JustinMaeder/Doct-senior-design-project/README.md

# Doct-senior-design-project
 CSULB 490B Senior Design Project- Doc't

Link to live demo:
https://www.youtube.com/watch?v=JGFx7sOTDQI

Link to Backend Final Demo:
https://youtu.be/M6DDF0WYpfE
