JustinMaeder/Doct-senior-design-project/CECS 490B-Final - Group Report.pdf

Doc’t 1 of 55

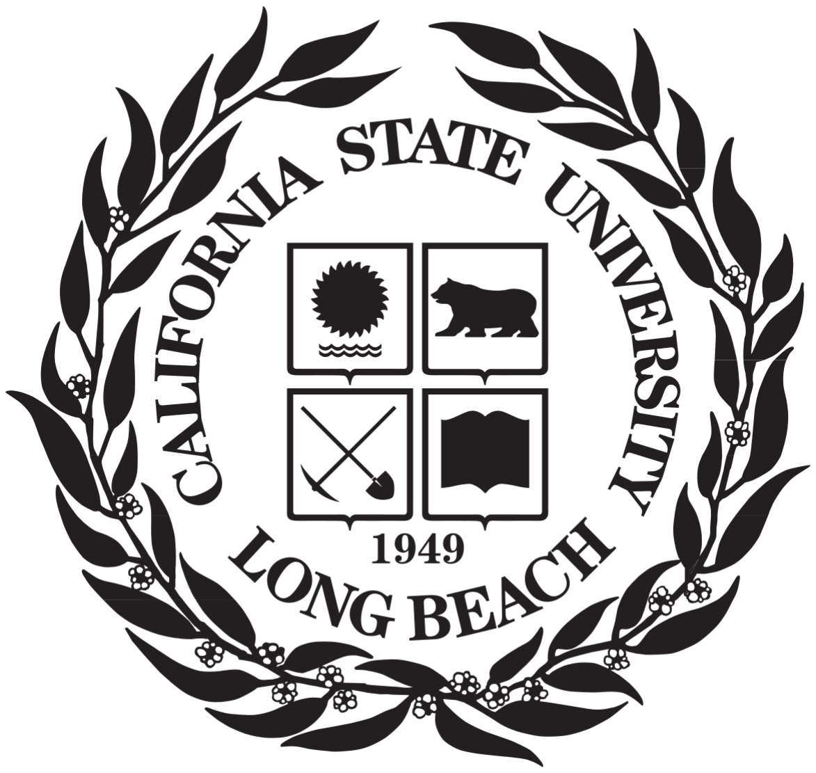
[picture p1: figure]

# Doc’t

## Final Group – Group Report CECS 490B

5-08-2020

## Justin Maeder & Hung Le

CONTENTS

1. INTRODUCTION

1.1 MEET THE TEAM

Justin Maeder

Justin.Maeder@student.csulb.edu

Responsible for:
1. Software Design
2. C++ for Arduino
3. Constructed Database
4. Created web application
5. Hardware verification

Hung Le

Hung.Le@student.csulb.edu

Responsible for:
1. Hardware Design
2. Wiring diagram
3. Hardware assembly/debug
4. Software Verification

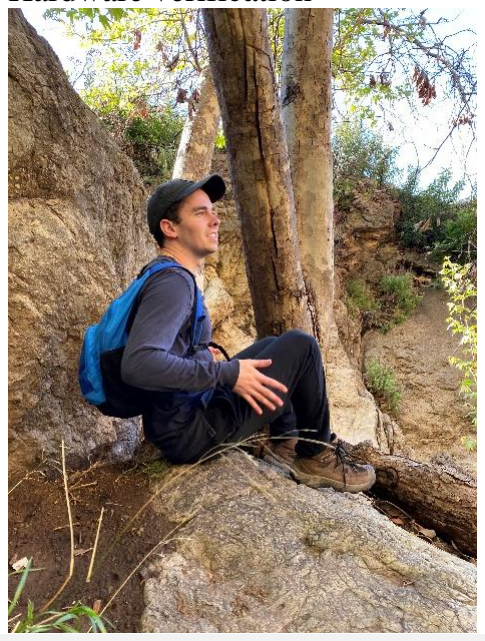
[picture p2: figure]

1.2 DOC’T

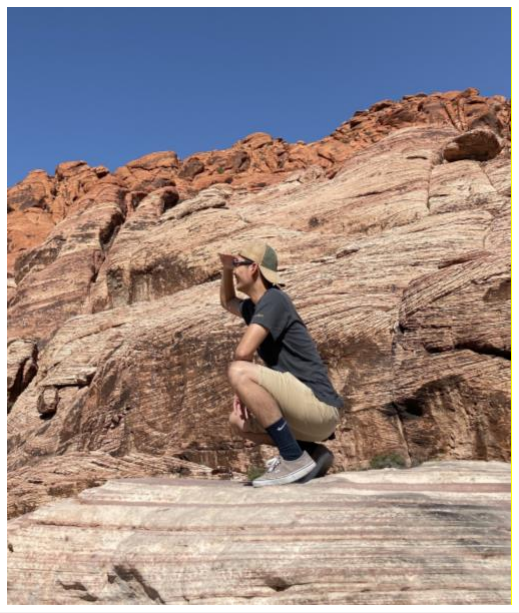
[picture p3: figure]

Doc’t is an electric transportation rental system with centralized locking and docking

charging HUBs and innovative safety equipment.

Our design consists of three main components. Primarily we will be building an Electric

Transportation System. Our ETS will include a custom electric skateboard. The second

component consists of a docking and locking HUBs. The "HUB" harnesses clean energy from

the sun using solar panels and store the energy in a power bank to charge and lock the vehicles.

Lastly, our safety features include a helmet with a Head-Up display to visualize the vehicle’s

vitals. The HUD will display the battery level, speed, range, efficiency, and current time.

2. SPECIFICATIONS

2.1 DESIGN SPECIFICATIONS
1. Frontend – Hackathon Boiler Plate with PUG JavaScript with MongoDB
a. Register User
i. Name
ii. Username
iii. Password
iv. Email
b. Login
c. Book Ride
i. Show closest available vehicle ii. Shows PIN
d. Forgot Password
e. Contact Page
f. Status of the server
g. My Account (Profile)
2. Backend
a. Using MySQL with PhpMyAdmin to interface
b. Virtual private server through Digitalocean:
i. 1 GB RAM
ii. 25 GB SSD
iii. 1 CPU
iv. 1 TB data transfer
v. $5.00/ month
1. ALL user registration information
2. Vehicle Information
a. Check in/out time
b. Range
c. Battery Usage
d. GPS
e. PIN
3. HUB – Charging Station
a. Charging station consists of a deep cycle SLA battery of 9AH. Enough to charge one vehicle from 0% to 100%.
b. This battery is recharged by a 25W solar panel.
c. A solar charge controller is used to safely charge the battery overtime.

d. Lastly a 500W inverter will convert the DC power from the battery to AC to charge the vehicle.
4. Physical Locker space:
a. The locking mechanism on the locker space will be controlled by the TTGO TCALL.
b. Locker space consists of the lockers with electronic locking solenoid and a keypad.
c. The system will be powered by the central battery and stepdown using the 7805-voltage regulator.
1. Locking mechanism
a. GPIO communication w/ each lock
2. Solar Panel Mounting
a. Deliver power to controller
3. Battery storage
a. Battery capacity to support number of ETS
4. Keypad for PIN input
5. Transportation Vehicle:
a. Physical vehicle
i. Deck
ii. Trucks
iii. Wheels
iv. Bearings
v. Motor mount
b. DC Motor
i. Single brushless belt driven DC motor that can generate 2900 Watts.
c. Electronic speed control module
i. Remote Control
ii. 7-segment display
d. Battery Bank
i. Dual battery bank that can provide a range of 7-8 miles range.
1. 5000mAh
e. ESP32 TTGO TCALL
i. GPS module
ii. Sim Card
6. Safety:
a. Helmet:
ii. Starting mechanism:
1. ETS will not function w/o the helmet strapped. iii. Head Up Display:
1. Arduino Nano driving OLED display:
a. Battery percentage
b. Speed
c. Range

d. Current Time
2. Bluetooth Communication using HM-10 transceiver
a. Remote
b. Vehicle
c. Helmet

2.2 MAIN COMPONENT DESCRIPTION

2.2.1 HUB

- ESP32 TTGO T-Call SIM800L for its internet connectivity and Bluetooth capabilities
- Power consumption: 2.85 W (~500mA) – 7.6 W (~640 mA) (idle – load)

The HUB will have its operating system that will allow users to reserve a locker space or to

borrow an electric transport. It will then display the available lock number to the user. If the user

wants to reserve a space, then it will prompt the user to enter a PIN to unlock the locker. The

main console will keep track of the time that the locker is being used and the power being

consumed if there is any.

An app will be available to the user so their information can be logged into the system and

communicates the information to the HUB. This will allow for ease of use where the user can

reserve space or transport using the app and arrive at the station with their space ready to use. To

conserve power, the HUB will go into sleep mode when it has been idling for a certain amount of

time.

HUB is completely self-sufficient in terms of power generation. Arrays of 25w solar panels.

HUB will also oversee the power level of the battery and the output levels of the solar panels.

Depending on the power of the battery, the power output to the users will be adjusted to prevent

the battery from going empty.

Skateboard will have 80-Watt Hour battery (36V at 4.5A) – range 7-8 miles. HUB will

consume around 3-8 Watts. Solar Panel outputs around 25 Watts. To support one skateboard a battery will have to be able to output at least 100W per skateboard. This is scalable to the

number of electric transport that the station will accommodate.

2.2.2 TRANSPORTATION VEHICLE

- C6374 – 170kV brushless belt driven DC Motor that generates 2900W chosen for reliability and cost.
- Turnigy 3s 5000mAh Battery bank for 80-Watt Hour to give the transportation vehicle 7-8 miles range.
- Using our current longboard for prototyping as we have not decided yet on a chassis.
- ESC (electric speed controller)

What is the appeal to those who cannot ride a skateboard? Doc’t presents an all-inclusive

solution by transforming into an easy-to-ride scooter all at the rider’s fingertips. When the

rider pulls up to the HUB, they will have the option to check out a scooter handlebar on the

reservation app which will click and lock into place on the transportation vehicle deck. The

remote will include a throttle potentiometer, a 1.5V battery, and LEDs to display the current

setting.

On the electric transportation vehicle side, we will have an ESC (electric speed

controller) to drive and control the motor. It will communicate via Bluetooth with the remote

to change motor speed and direction. The ESC will also monitor the battery level and an

ESP32 will transmit that data to the safety system.

2.2.3 SAFETY SYSTEM

Our Rider’s safety is the number one priority. Here are a few ways to ensure the safety of

transportation. First, we created to have a smart helmet. This will also cause the transportation

vehicle to active ensuring that the rider is wearing the helmet. The smart helmet will have a

Head-Up display which will display the board’s vitals such as batter level, range, speed, current

and time.

3. PARTS REQUIRED

3.1 SAFETY SYSTEM

3.1.1 HEAD UP DISPLAY

Part name | Quantity
Arduino Nano | 1
HM-10 Bluetooth module | 1
Adafruit MicroLipo Battery Charger | 1
3.7V 850 mAh lipo battery | 1
DIY mall 0.96” OLED module | 1
100mm double convex glass lenses | 1
0.096” thick acrylic sheet | 1
Mirror | 1
3d printed casing | 5

3.2 VEHICLE

3.2.1 DRIVING MECHANISM

Part name | Quantity
Longboard skateboard | 1
C6374 brushless motor 170Kv | 1
Electric Skateboard flywheel pulley drive kit | 1
Single motor electric skateboard controller ESC | 1
6S 25.2V Li-ion 18650 Lithium Battery BMS | 1
XT60 battery connectors | 2
Nano Sim Card | 1

3.2.2 GPS SYSTEM

Part name | Quantity
ESP-32 TTgo T-call | 1
REYAX RY8253F 10Hz GPS module | 1
BINZET DC Converter step down regulator 5V | 1

3.3 LOCK & DOCKING HUB

3.3.1 POWER SYSTEM

Part name | Quantity
Renogy Wanderer 10 Amp 12v/24v PWM Solar charge controller | 1
ECO-WORTHY 12v 25w Solar Panel | 1
ML9-12 12v 9Ah Rechargeable SLA battery | 1
POTEK 500W Inverter DC 12v to AC 110v | 1

3.3.2 LOCKING SYSTEM

Part name | Quantity
ESP-32 TTgo T-call | 1
Adafruit 3x4 matrix keypad | 1
GROVE relay module | 1
Atoplee Electric Lock Assembly Solenoid DC 12v | 1
12V battery source | 1

4. CONTRUCTING DESIGN

4.1 SAFETY SYSTEM

4.1.1 HARDWARE

3D PRINTED CASING

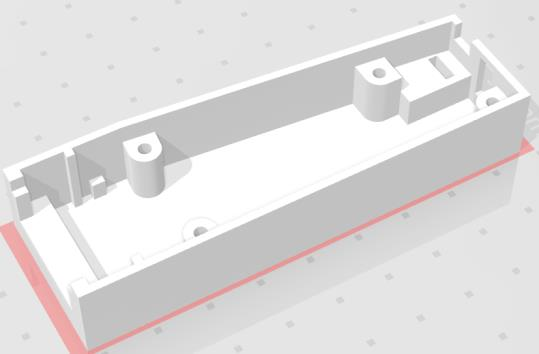
[picture p4: figure]

Figure 1 - PART A

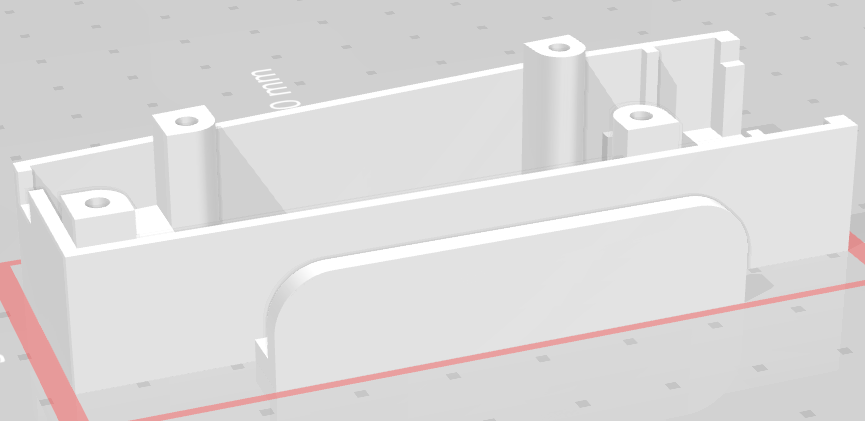
[picture p5: figure]

Figure 2 - PART B

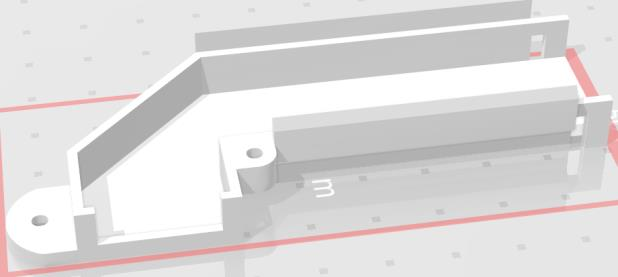
[picture p6: figure]

Figure 3 - PART C

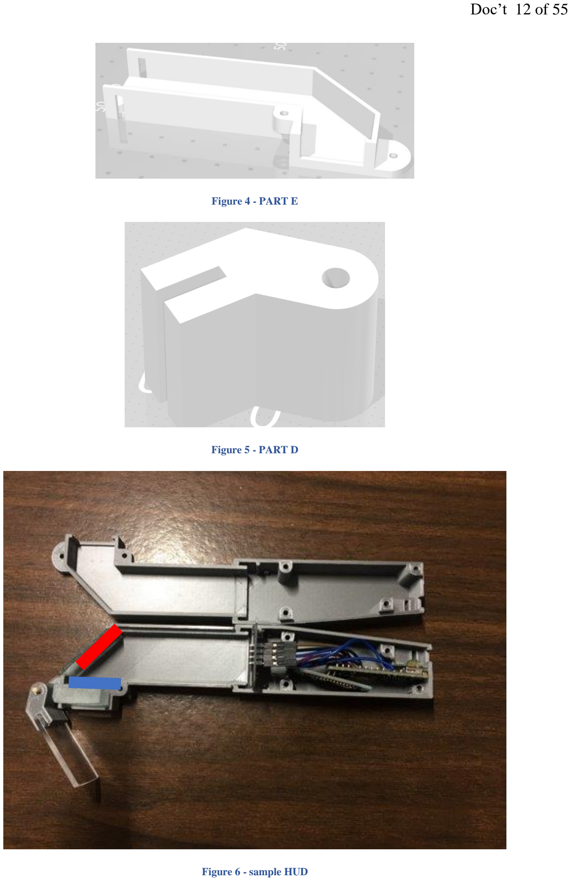
[picture p7: page 12]

Figure 4 - PART E

Figure 5 - PART D

Figure 6 - sample HUD

- The Head Up Display casing can be 3d printed with the 3d model provided below.
- Cut the mirror to fit into the red space above.
- Cut the double convex lens to fit into the blue highlight space
- Cut acrylic sheet into 1”x1.5”in rectangle and secure with glue into part D.

WIRING DIAGRAM

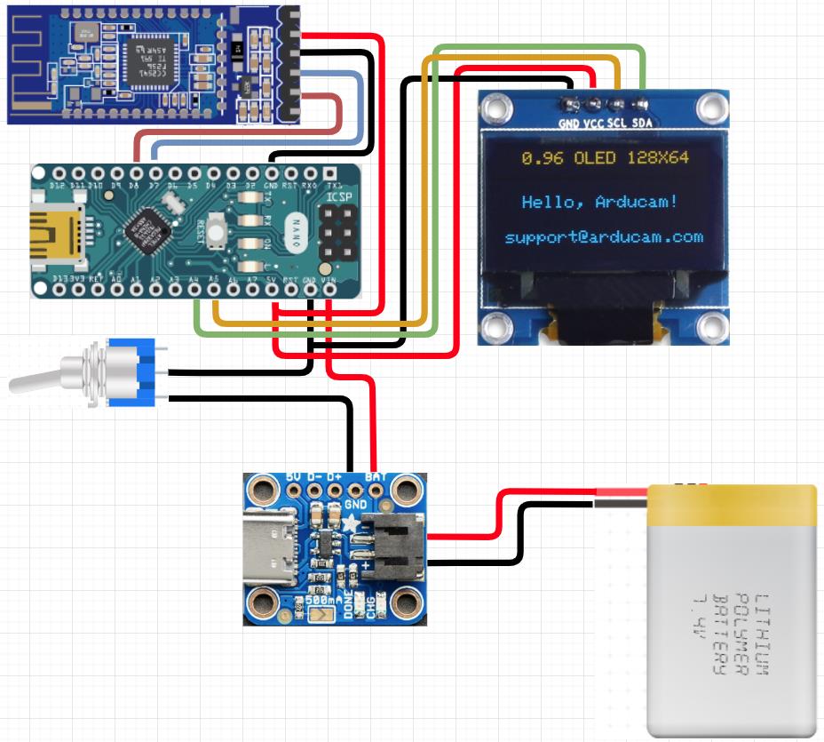
[picture p8: figure]

Figure 7 - HUD wiring

ASSEMBLED DESIGN

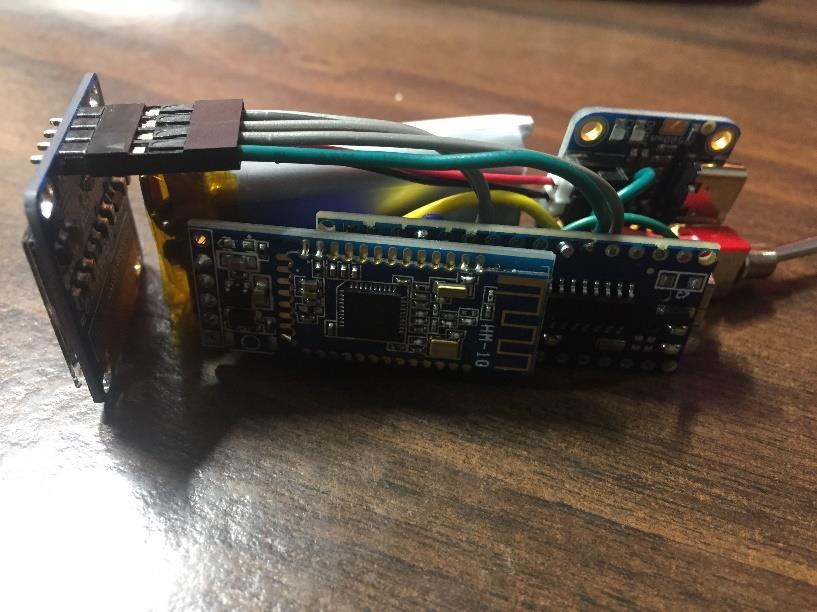
[picture p9: figure]

Figure 8 - Assembled HUD 1

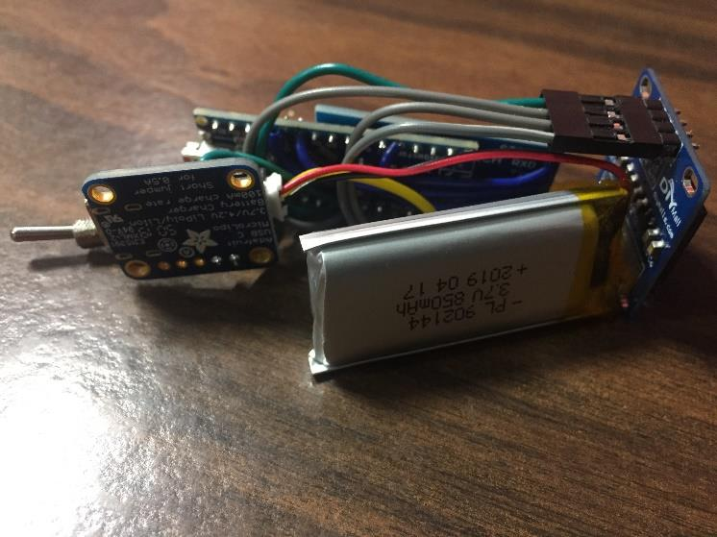
[picture p10: figure]

Figure 9 - Assembled HUD 2

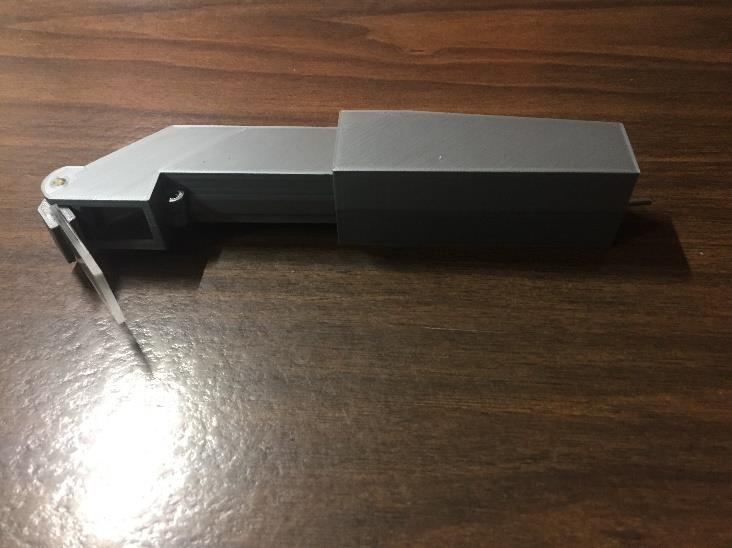
[picture p11: figure]

Figure 10 - Assembled HUD 3

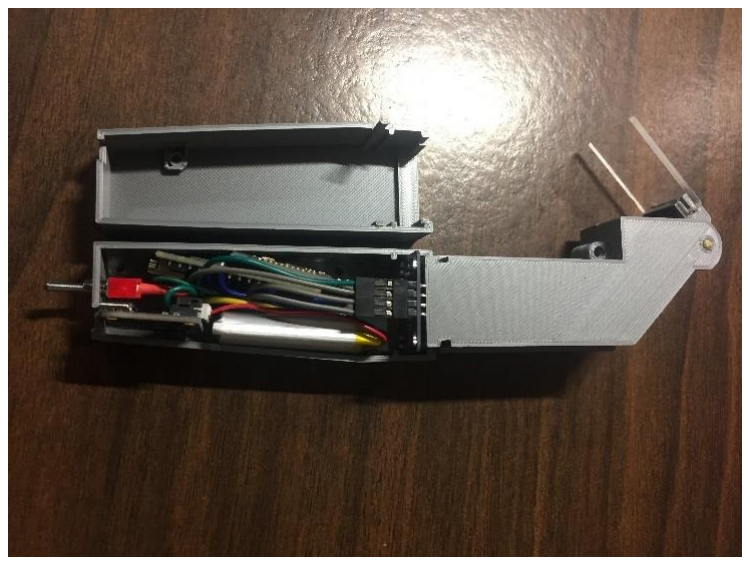
[picture p12: figure]

Figure 11 - Assembled HUD 4

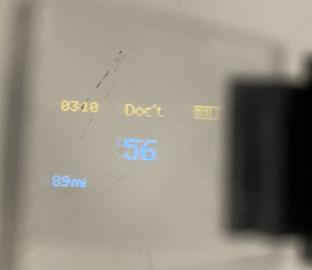
[picture p13: figure]

Figure 12 - Head up display view

4.1.2 SOFTWARE DESCRIPTION

Full software files provided bellow.

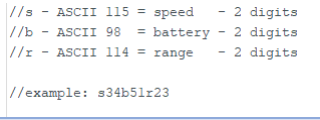
[picture p14: figure]

Input string to send to HM-10

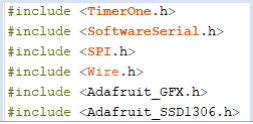
[picture p15: figure]

Libraries used.

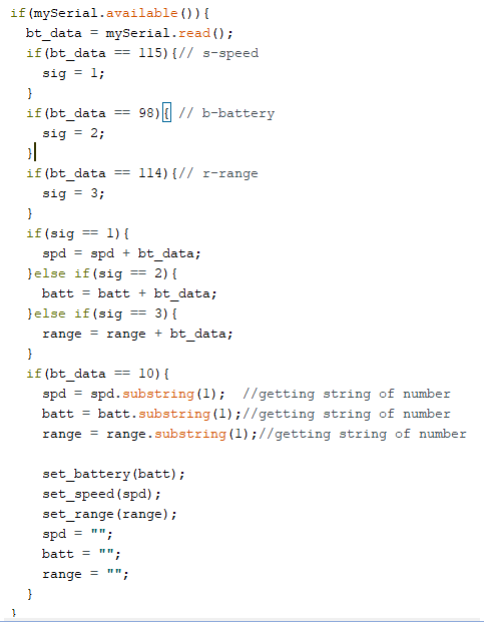
[picture p16: figure]

Decoding method to decode
data according to inputs

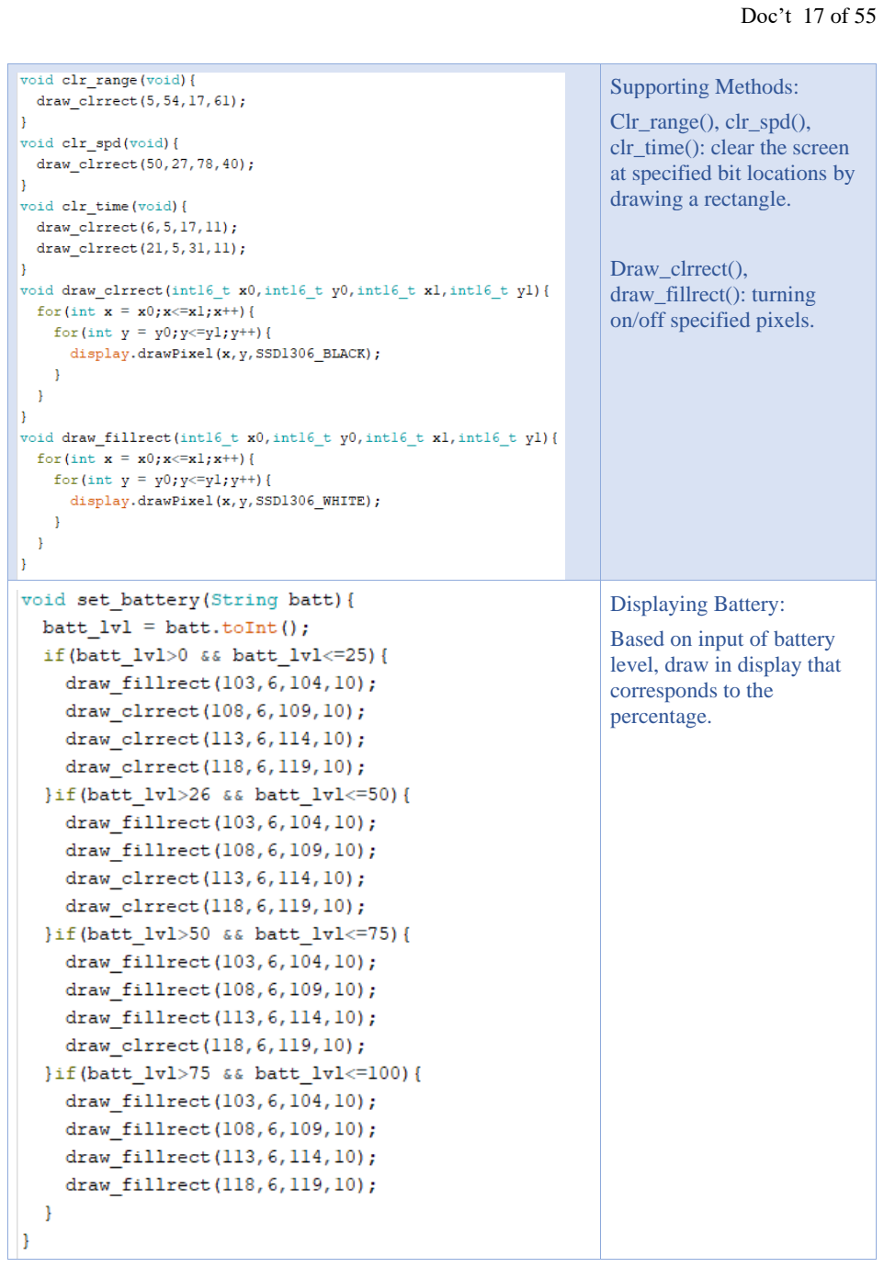
[picture p17: page 17]

Supporting Methods:
Clr_range(), clr_spd(),
clr_time(): clear the screen at specified bit locations by drawing a rectangle.

Draw_clrrect(),
draw_fillrect(): turning
on/off specified pixels.

Displaying Battery:
Based on input of battery
level, draw in display that corresponds to the
percentage.

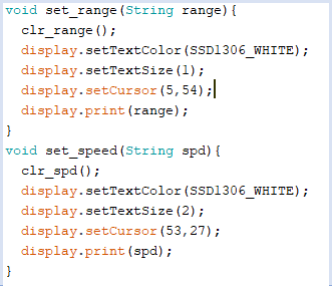
[picture p18: figure]

Display range/speed:
Based on input of speed and range. Write the numbers on the display at specified
locations.

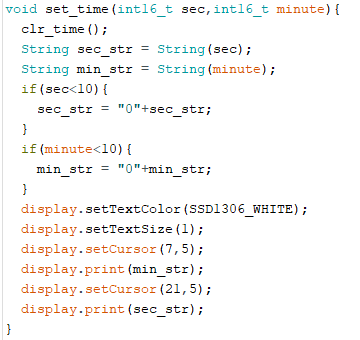
[picture p19: figure]

Timer:
Display the timer since the device has been powered
on. Time is in hr-min
format.

4.2 VEHICLE

4.2.1 HARDWARE

DRIVING MECHANISM

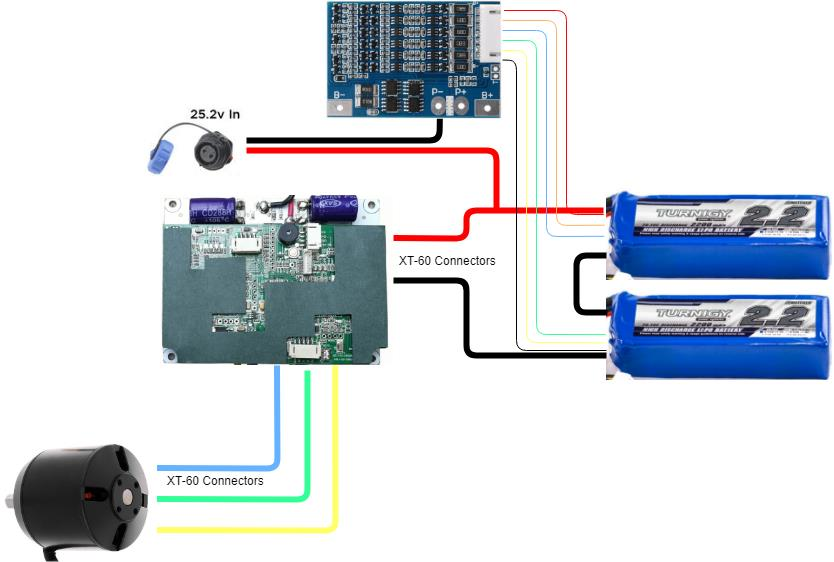
[picture p20: figure]

Figure 13 - Driving system connection

- 5000mAh 11.1V batteries, BMS (battery management system), connectors.
- Connect the two batteries in series using connectors.
- Wire BMS in parallel with batteries. BMS will be used to charge the batteries.
- Connect battery to ESC
- ESC and remote
- Connect power input wires to battery.
- Connect the 3 phase wires to motor. Connect motor control wires to ESC.

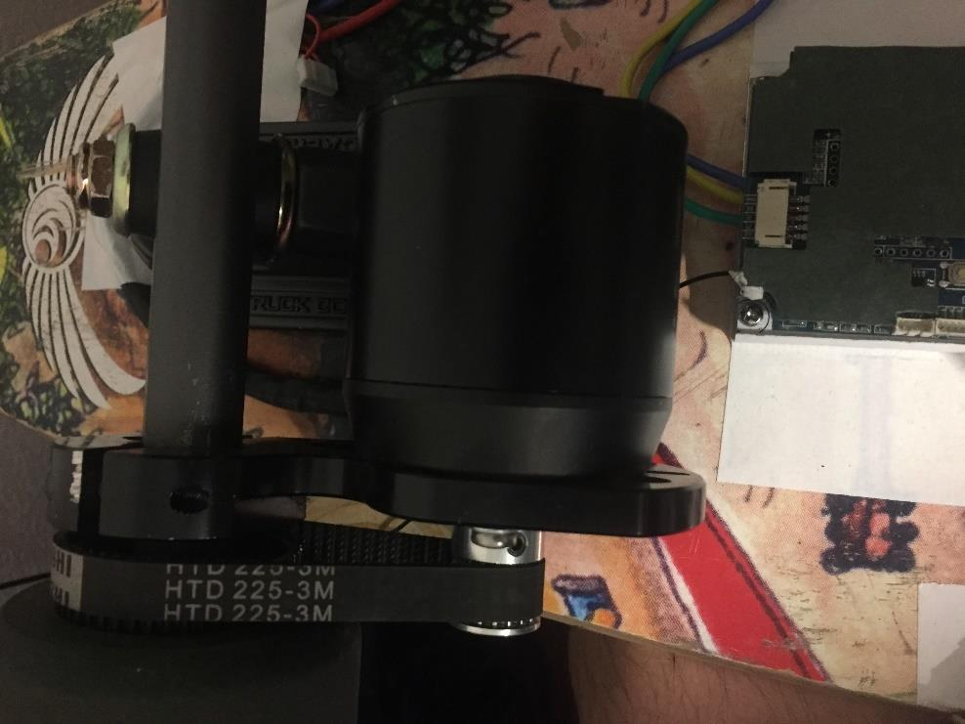
[picture p21: figure]

Figure 14 - Motor Mounting

- Trucks, motor mount, pulley system, motor, wheels.
- Bolt front and rear trucks to board.
- Attach motor mount to rear truck. Bolt motor onto motor mount.
- Attach pulley gear to motor. Attach pullet gear to wheel. Put drive belt connecting motor and wheel.

GPS SYSTEM

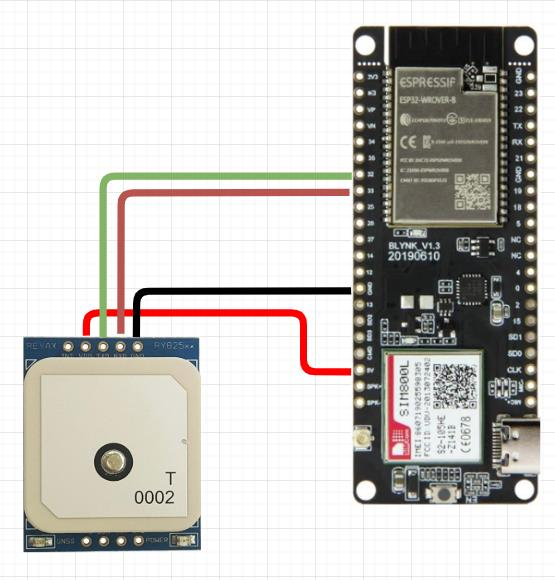
[picture p22: figure]

Figure 15 - GPS-ESP32 Wiring

- LILYGO TTGO T-Call V1.3 ESP32, REYAX RY8253F 10Hz GPS, SIM card
- Setup ESP32 to communicate with server.
- Setup ESP32 for Bluetooth communication.
- GPS module connected to ESP32 via UART protocol. ESP32 will receive GPS data and send data of the location back to the server via 2G.

ASSEMBLED DESIGN

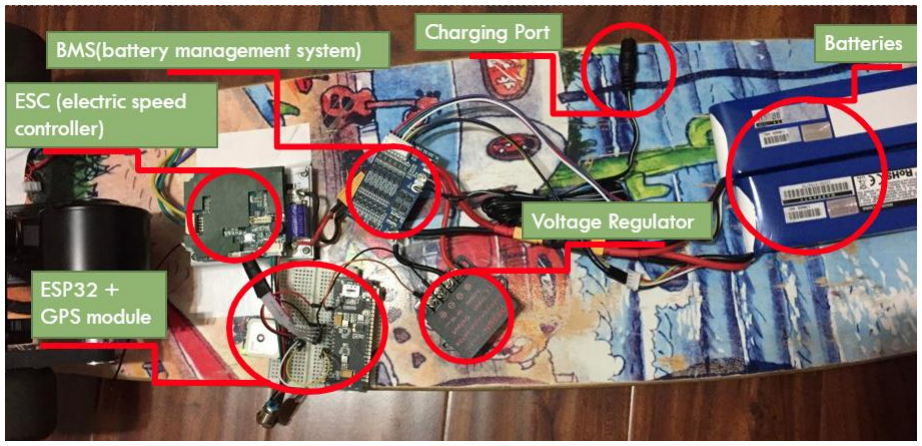
[picture p23: figure]

Figure 16 - Assembled vehicle

4.2.3 SOFTWARE DESCRIPTION

- GPS tracking:
- ESP32 development will be in Arduino IDE environment using C.
- Set up UART communication between GPS module and ESP32. Each vehicle will have an identifying number.
- Process GPS data. Send out GPS data along with identification number to server via data using 2G network.
- Location will be sent every 15 seconds.

Libraries used.

APN, Server, Port setup

Feeding data from GPS module to TinyGPS++ library.

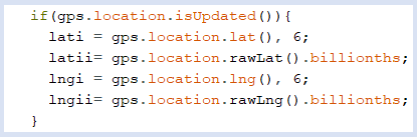
[picture p24: figure]

Get latitude
and
longitude to
the billionths
decimal
place from
GPS
module.

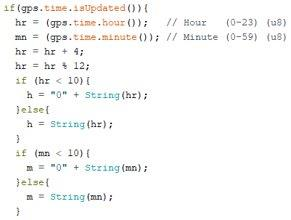
[picture p25: figure]

Get an
accurate
time Pacific
Standard
time with
Spring Day
Light
Savings
Time taken
from GPS
module.

Library for Bluetooth connection.

MAC ID of HM-10 for connection.

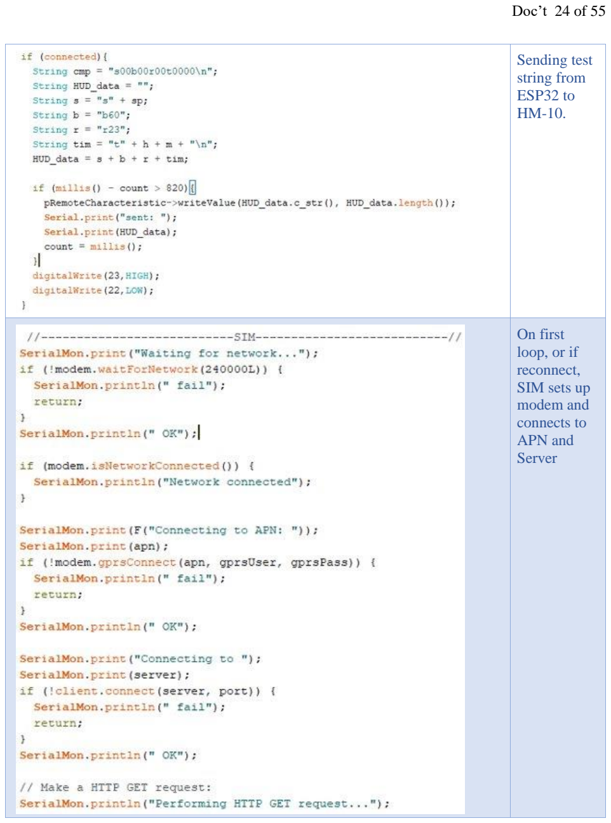
[picture p26: page 24]

Sending test
string from
ESP32 to
HM-10.

On first
loop, or if
reconnect,
SIM sets up
modem and
connects to
APN and
Server

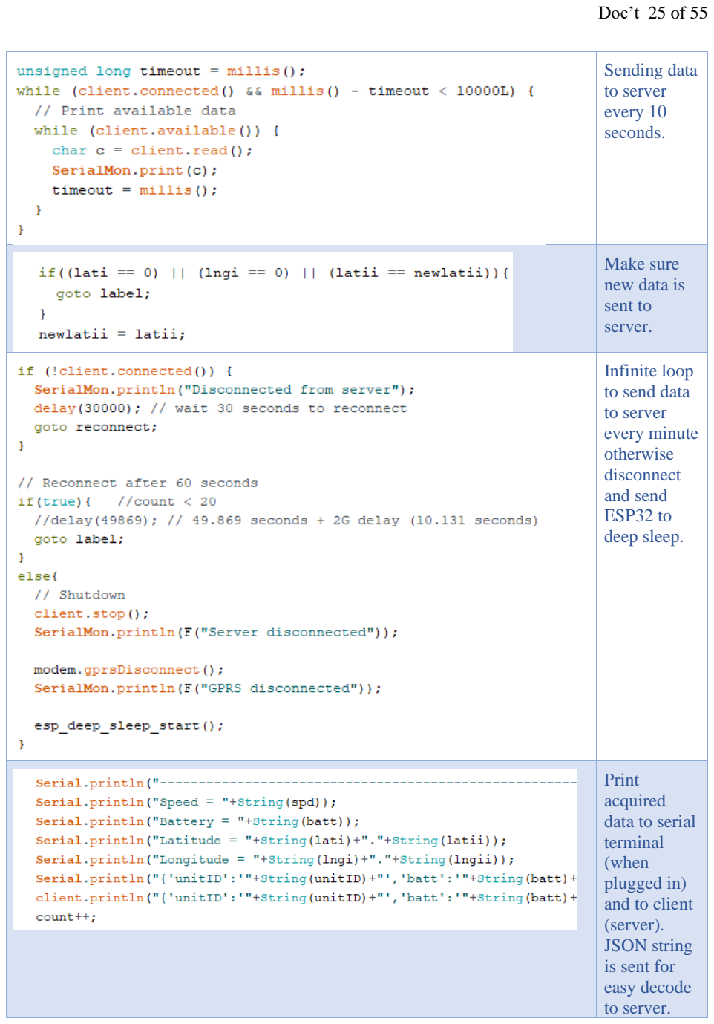
[picture p27: page 25]

Sending data to server every 10 seconds.

Make sure new data is sent to server.

Infinite loop
to send data
to server
every minute
otherwise
disconnect
and send
ESP32 to
deep sleep.

Print
acquired
data to serial
terminal
(when
plugged in)
and to client
(server).
JSON string
is sent for
easy decode
to server.

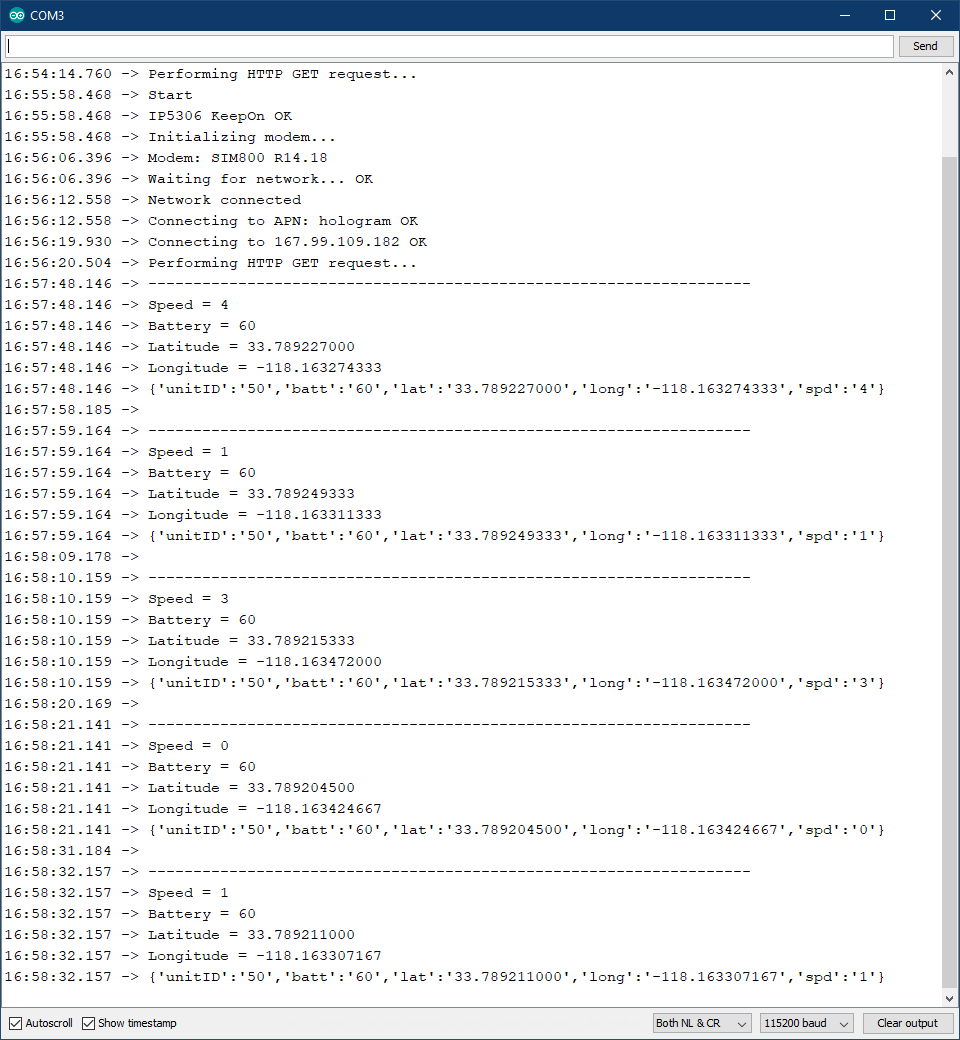
[picture p28: figure]

Figure 17 Serial Terminal for vehicle showing outputs and sent JSON data from vehicle 2G SIM every 10 seconds.

4.3 LOCKING & DOCKING HUB

4.3.1 HARDWARE

LOCKER

- The locker can be constructed from any desired material (wood, metal). Locker should be

large enough to fit the vehicle. This locker is smaller for demonstration purposes.

- Note in figure 17, there is a slit in the door for the wires to connect to the keypad.

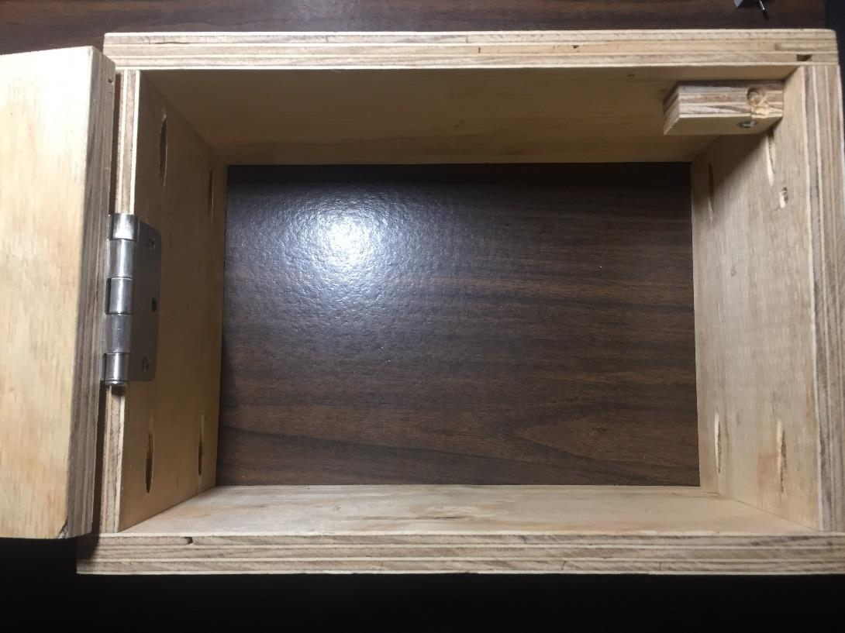
[picture p29: figure]

Figure 18 - Locker inside

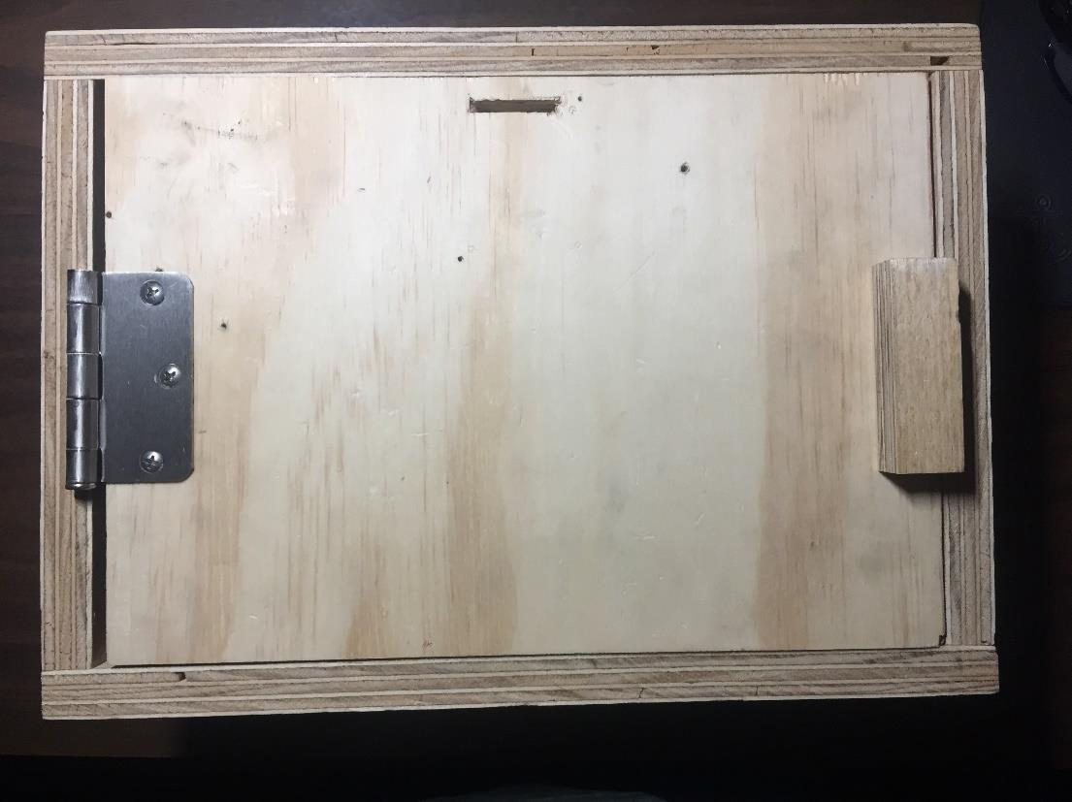
[picture p30: figure]

Figure 19 - Locker outside

LOCKING MECHANISM

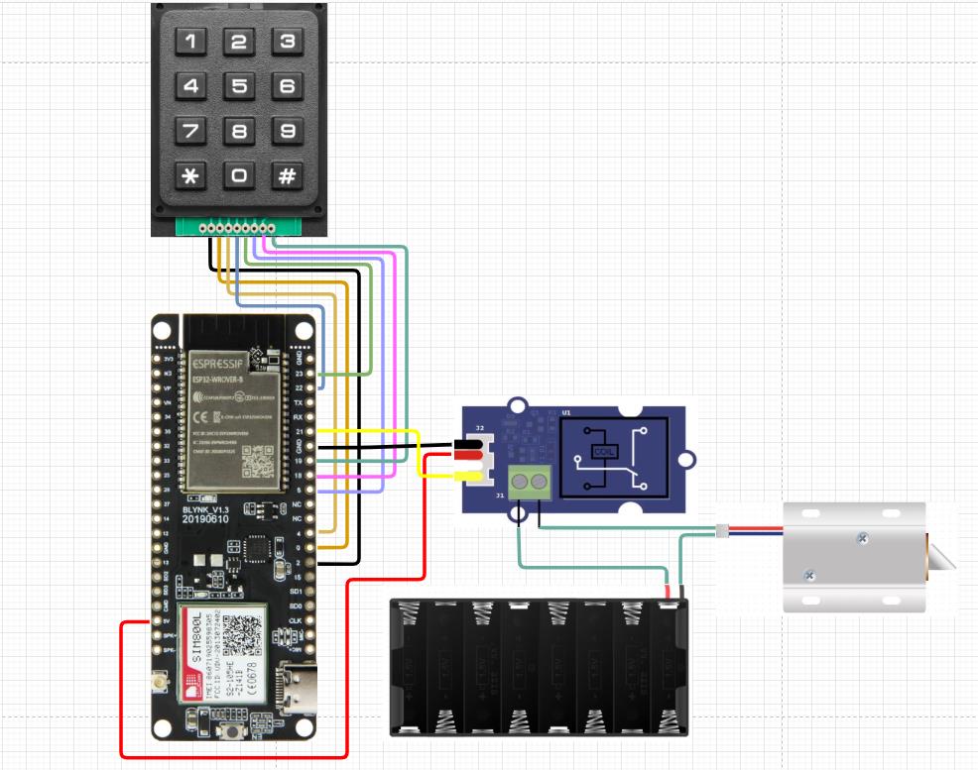
[picture p31: figure]

Figure 20 - Locking mechanism wiring diagram

SOLAR POWER SYSTEM

- The solar system described in figure 19 is rated for 100w solar panel, so 20A inline fuses are in place to protect from over current.
- For smaller solar system, as will be demonstrated, inline fuses will not be necessary as the charge controller can modulate the current sufficiently.

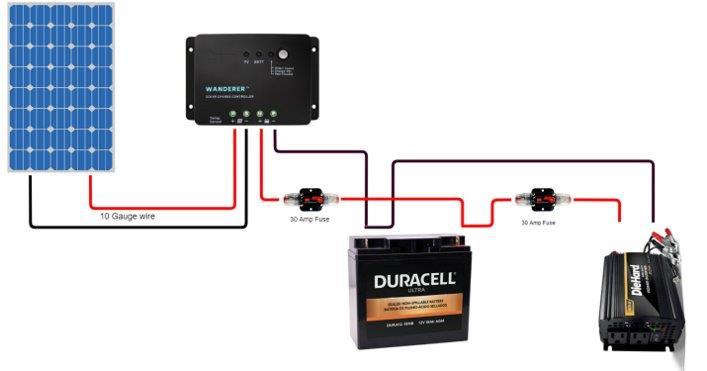
[picture p32: figure]

Figure 21 - Solar system diagram

- Solar Panel:
- Wire solar panel with 10-gauge wire.
- Connect power wires to input of charge controller.
- Charge controller:
- Wire charge controller with 10-gauge wire.
- Connect +/- output of charge controller to +/- terminals of battery.
- Add 30A inline fuse to the + wire from the charge controller to the battery.
- Inverter:
- Wire inverter with 10-gauge wire.
- Connect inverter +/- cables to +/- terminals of battery.
- Add 30A inline fuse to the + wire from the battery to the inverter.

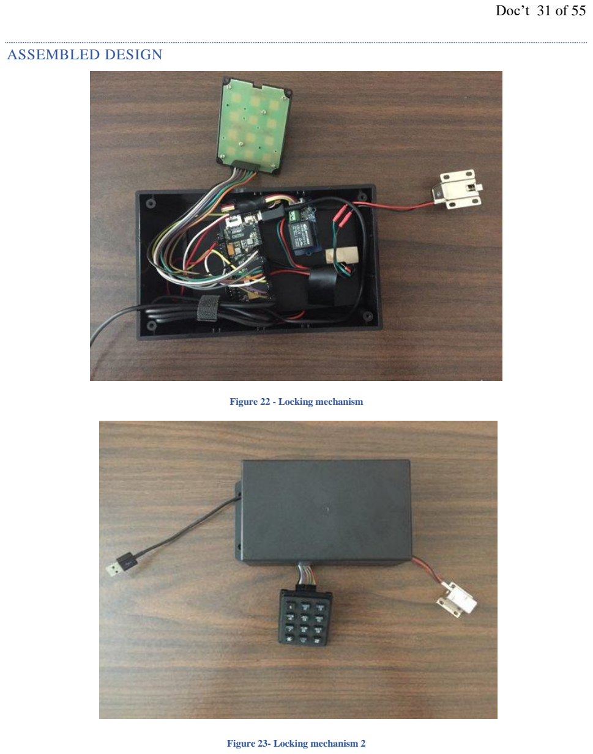
[picture p33: page 31]

ASSEMBLED DESIGN

Figure 22 - Locking mechanism

Figure 23- Locking mechanism 2

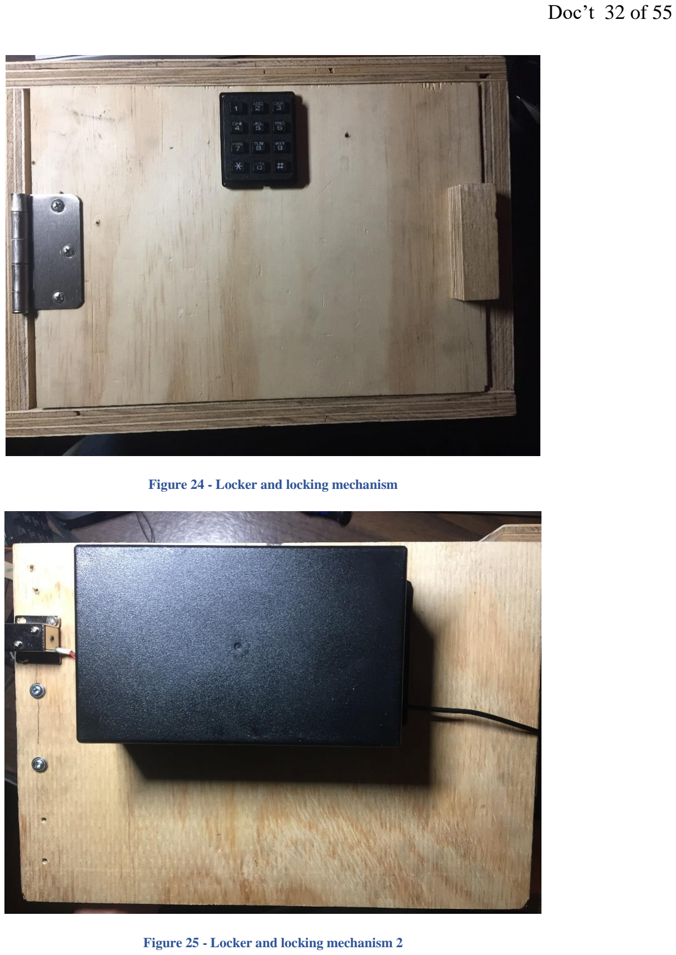
[picture p34: page 32]

Figure 24 - Locker and locking mechanism

Figure 25 - Locker and locking mechanism 2

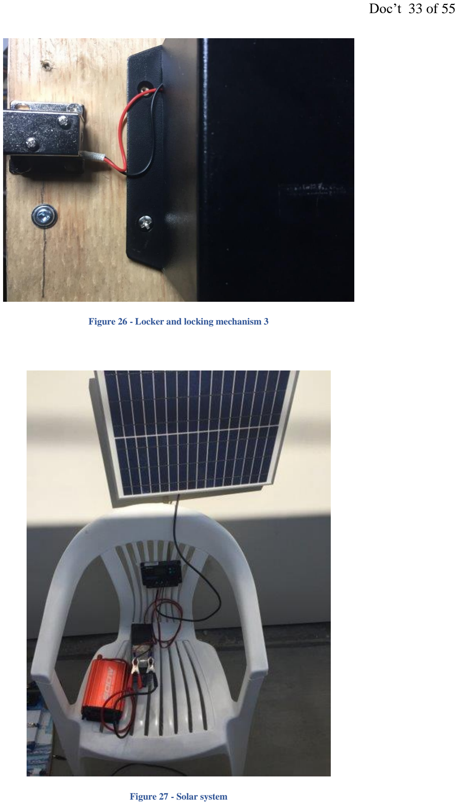
[picture p35: page 33]

Figure 26 - Locker and locking mechanism 3

Figure 27 - Solar system

4.3.2 SOFTWARE DESCRIPTION

- ESP32 TTGO T-Call:
- Receive data from keypad. Decode data from keypad to a PIN number.
- Match PIN number to data base.
- Unlock locking solenoid via GPIO if PIN matches.

Two libraries used for communication with the keypad and WIFI

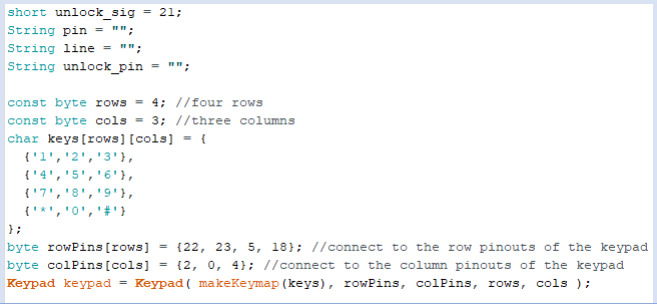
[picture p36: figure]

Initializing the 3x4 matrix keypad.

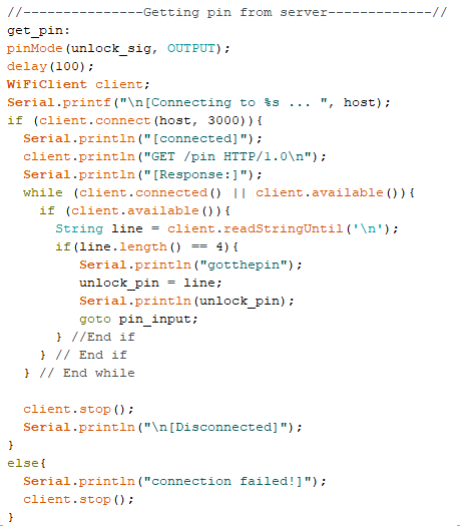
[picture p37: figure]

Http get request
to gather data
from the server.
Data in this case
is the 4-digit pin.

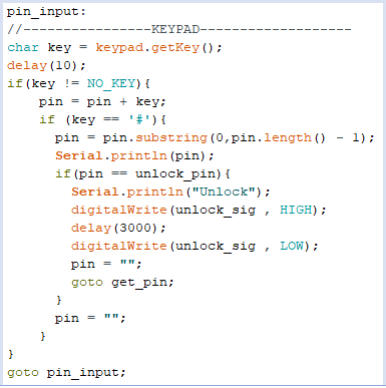
[picture p38: figure]

Once pin is
received, wait for
input from the
keypad. Then
compare the
input pin to the
unlock pin
received from
sever. If the pins
match, send a
signal which will
unlock the
solenoid.

4.4 SERVER & DATABASE

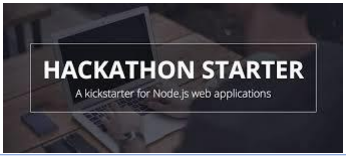
[picture p39: figure]

First, we downloaded the hackathon boilerplate.

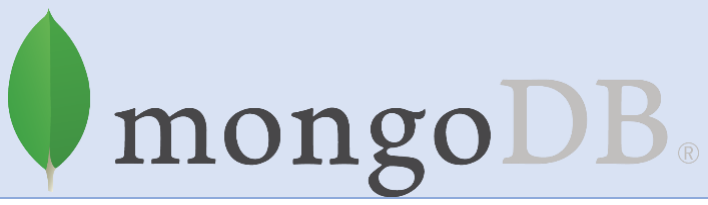
[picture p40: figure]

The boilerplate comes with mongoDB which is a built-in database to hold the user’s private information securely.

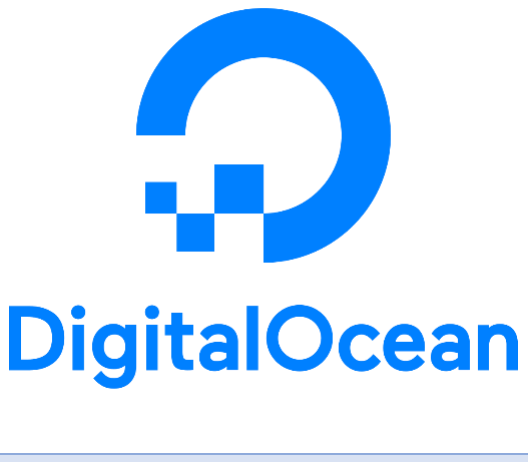
[picture p41: figure]

We bought a server on DigitalOcean with one Gigabyte of RAM, 25 Gigabytes storage, one CPU, and one Terabyte data transfer for only $5 per month.

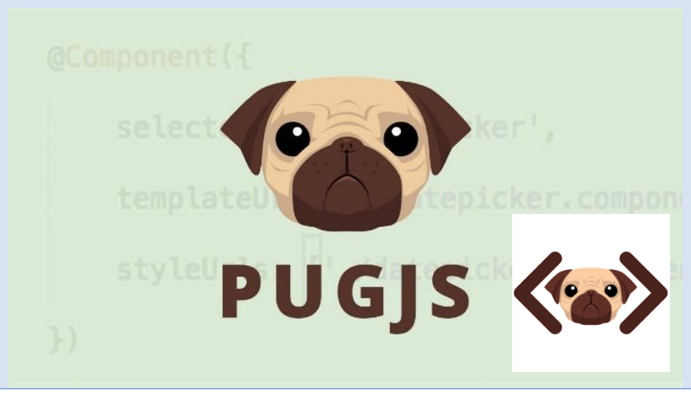
[picture p42: figure]

The application frontend is programmed with pug JavaScript and CSS onto a website domain http://doct.fbi.moe/.

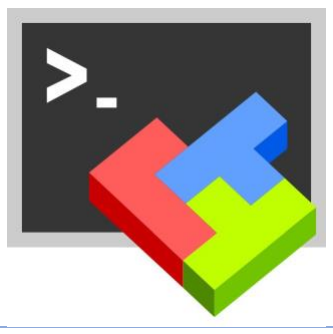
[picture p43: figure]

To interface with the database, we are utilizing MobaXTerm with an SSH protocol.

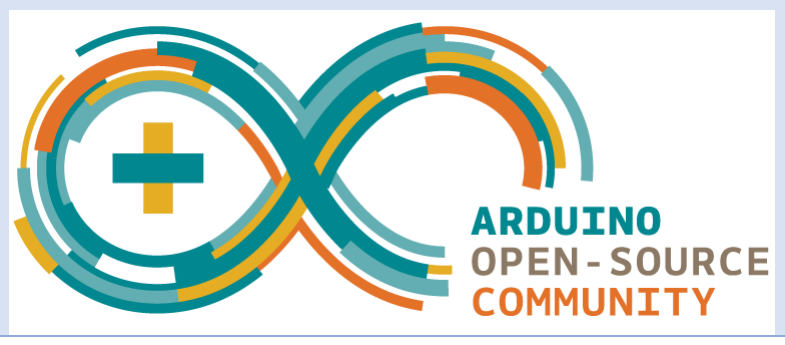
[picture p44: figure]

We program in C++ on
Arduino IDE to program the ESP32 TTGO TCALL
Wrover chip to gather
information communicate
with the server.

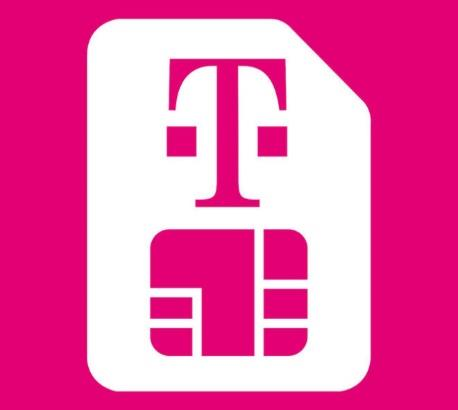
[picture p45: figure]

Every 15 seconds we
concatinated these values into JSON format and sent the
string data from the ESP32 TTGO TCALL through the
modem with a sim card over 2G network with T-mobile
carrier and Hologram APN.

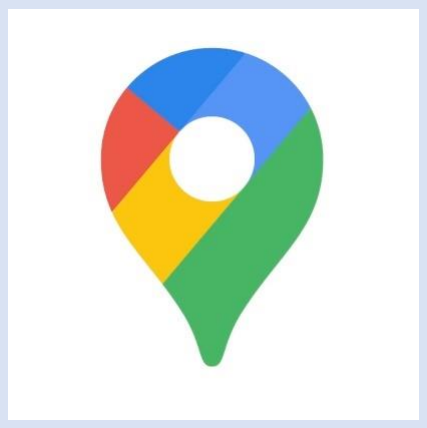
[picture p46: figure]

Once the server receives this information, the latitude and longitude are inputs to the Google Maps API and give a live update on where the
vehicle is in the world.

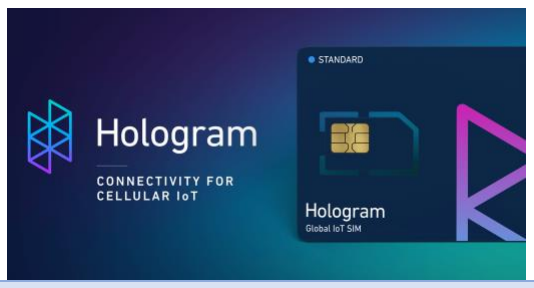
[picture p47: figure]

SERVER COMMUNICATION FLOW

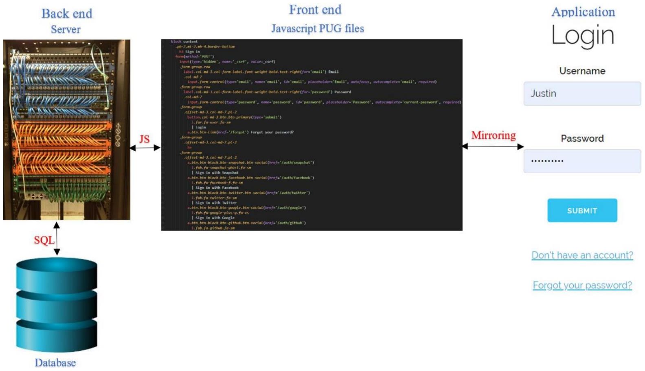
[picture p48: figure]

SOFTWARE
The second part of this project was constructing the application. First, we downloaded the hackathon boilerplate. We then bought a server on Digitalocean with one Gigabyte of RAM, 25 Gigabytes storage, one CPU, and one Terabyte data transfer for only $5 per month. The application frontend is programmed with pug JavaScript and CSS onto a website domain http://doct.fbi.moe/.

The register-user page will give riders the option to register as a new user with name, username, password, and email. Each user password is encrypted. Next, the user can login and request a vehicle, and the closest available vehicle will display as well as a server 4-digit RNG PIN. If the user forgets their password, then there will be a page to change their password. We have also setup a contact us page if there are any comments or advice for our electric transportation system. The server status is also available for the developers to make sure all of our software and hardware is doing what it is supposed to do.

The backend consists of the server and database. To interface with the database, we are utilizing MobaXTerm with an SSH protocol. In the database we are storing all the private rider’s information as well as the vehicle information. The vehicle information includes the time that the vehicle has been checked out and when it will be checked in, the range in miles, the current battery percentage, the current GPS location (longitude and latitude, and the temporary 4 digit PIN given to the user to check out the vehicle from the Doc’t HUB. The server will also contain the front end which contains the graphical user interface. The user will be able to go through our easy-to-navigate website to select a ride and get to their final destination with ease. The web application will mirror the front end to prevent the users from accessing confidential interface from our private database as an extra security precaution.

4.4.1 DATABASE

As mentioned, before we purchased a server through Digitalocean to handle our database, website, and application. First, we utilized hackathon boilerplate which uses PUG JavaScript to create a template for the frontend. We then modified it to include a homepage and pages for the user to register, login, book ride, My Account, forgot password, and status page. The boilerplate comes with mongoDB which is a built-in database to hold the user’s private information securely. All the pages are currently displayed in the upcoming figures of this section.

The GPS module uses the TinyGPS++ library to extract and decode GPS information. From this we pulled the latitude, longitude, range, battery, speed, and time. For our purposes we only neeeded this information every one minute. Every 15 seconds we concatinated these values into JSON format and sent the string data from the ESP32 TTGO TCALL through the modem with a sim card over 2G network with T-mobile carrier and Hologram APN. Once the server receives this information, the latitude and longitude are inputs to the Google Maps API and give a live update on where the vehicle is in the world. All of this is shown in extensive detail with pictures in this section.

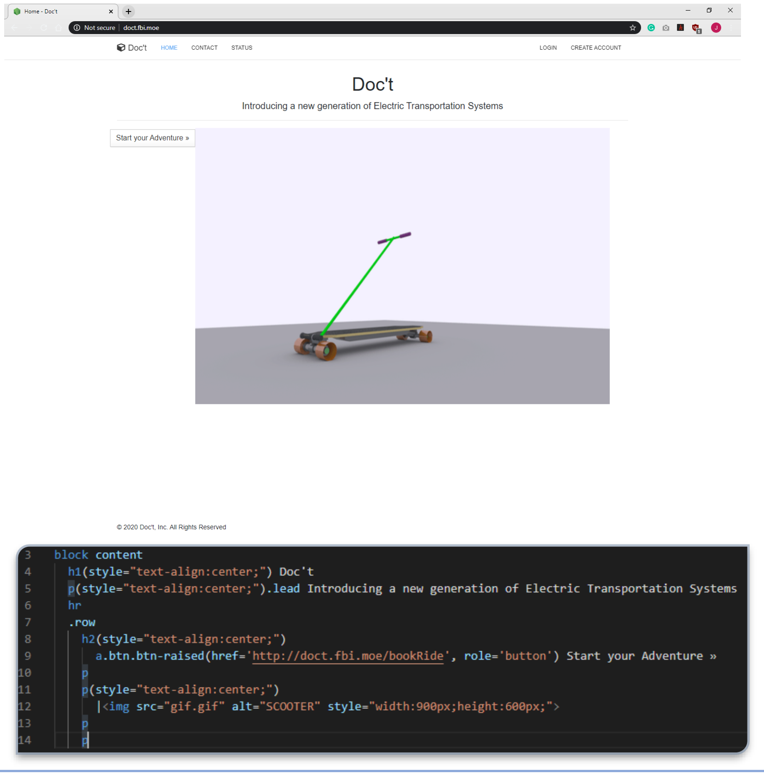
[picture p49: figure]

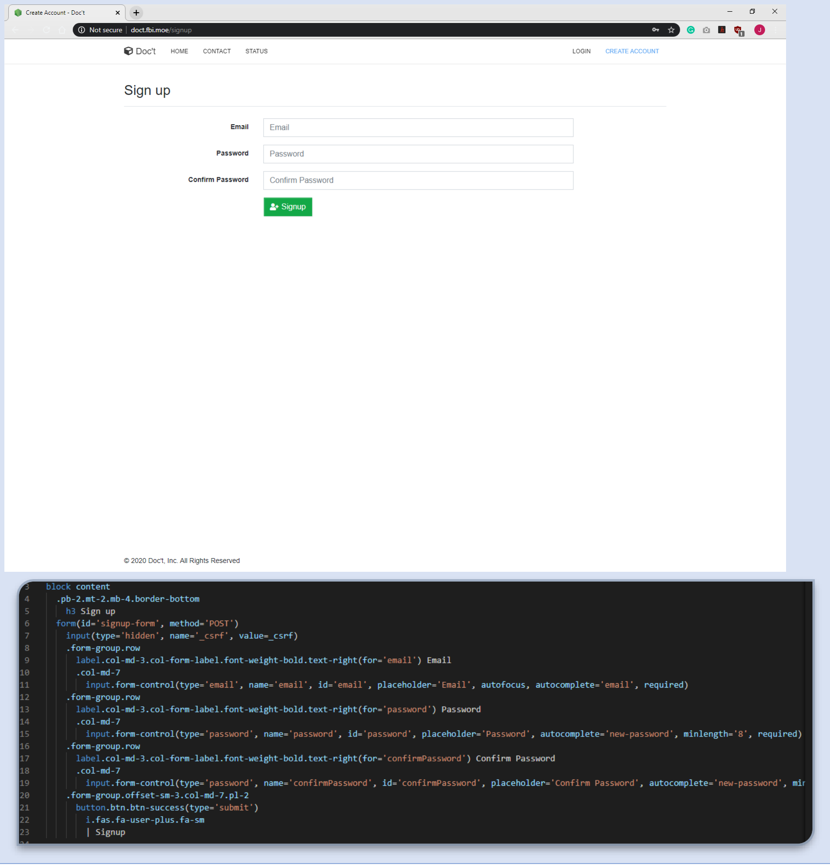
[picture p50: figure]
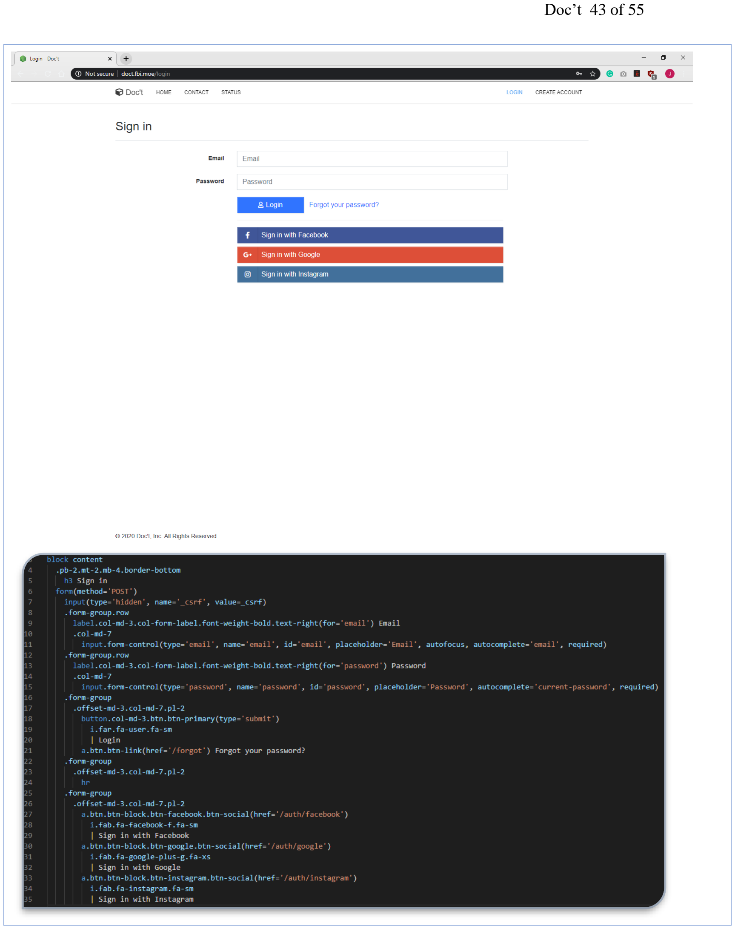
[picture p51: page 43]
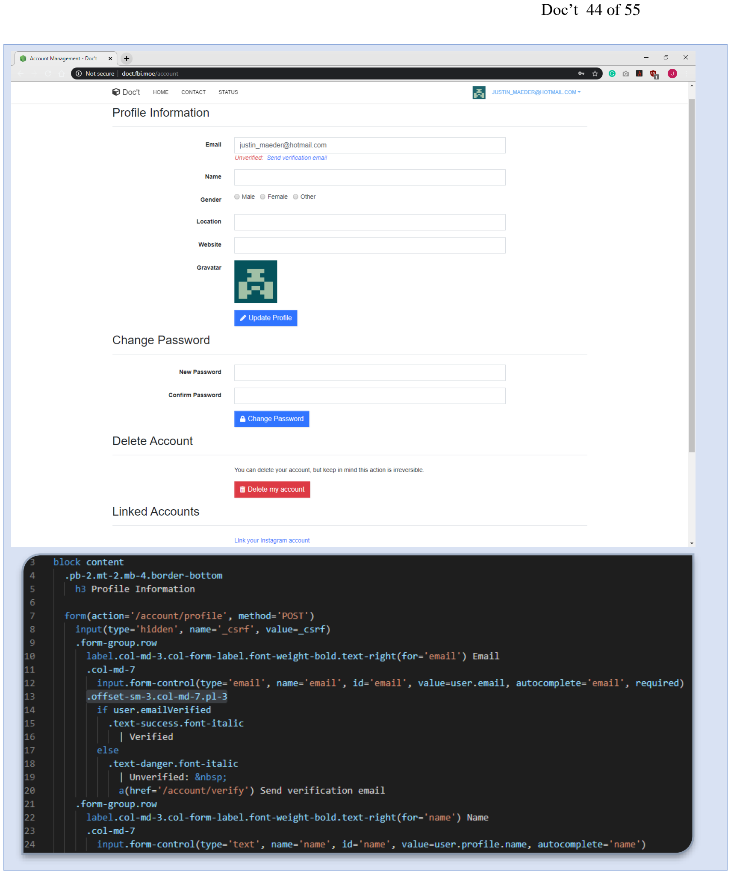
[picture p52: page 44]

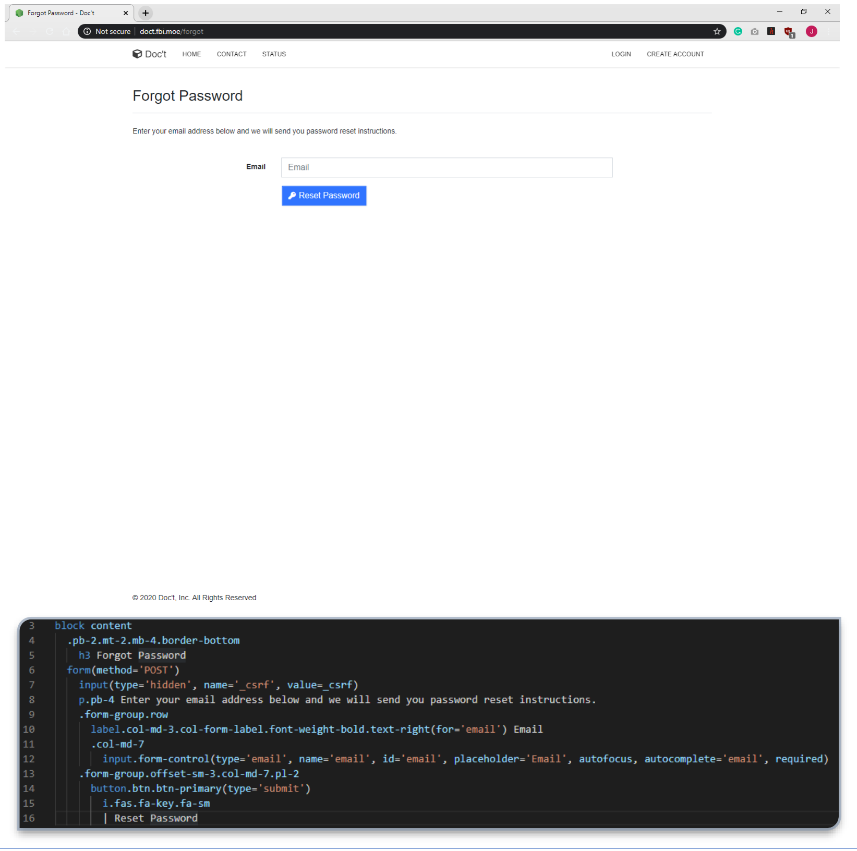
[picture p53: figure]

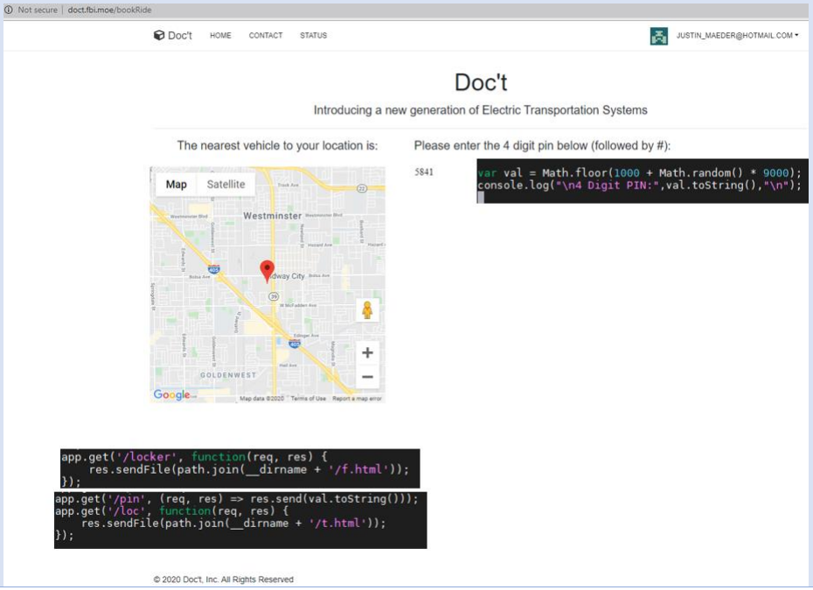
[picture p54: figure]
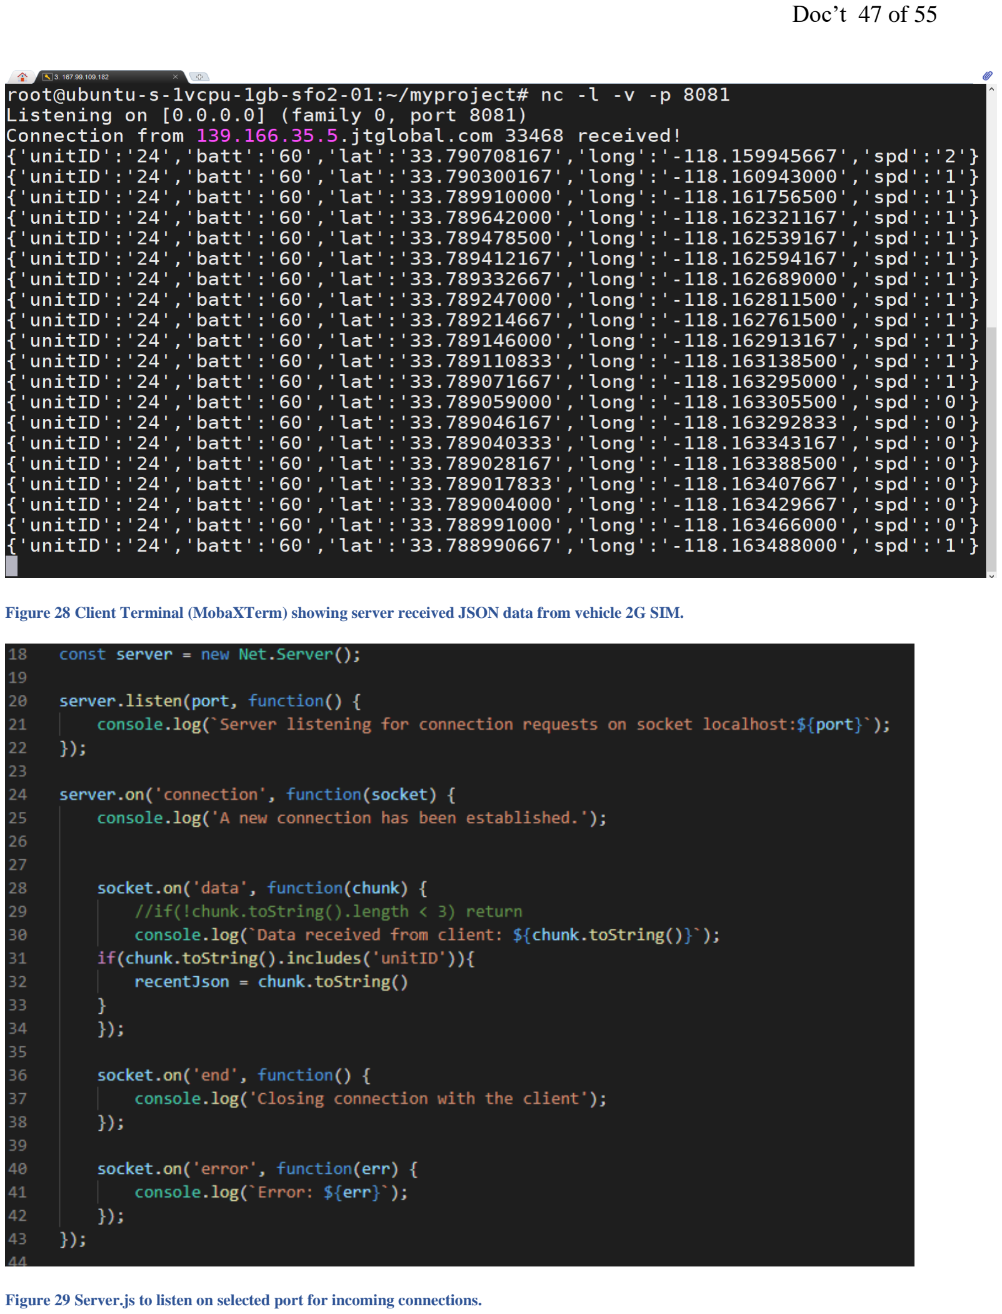
[picture p55: page 47]

Figure 28 Client Terminal (MobaXTerm) showing server received JSON data from vehicle 2G SIM.

Figure 29 Server.js to listen on selected port for incoming connections.

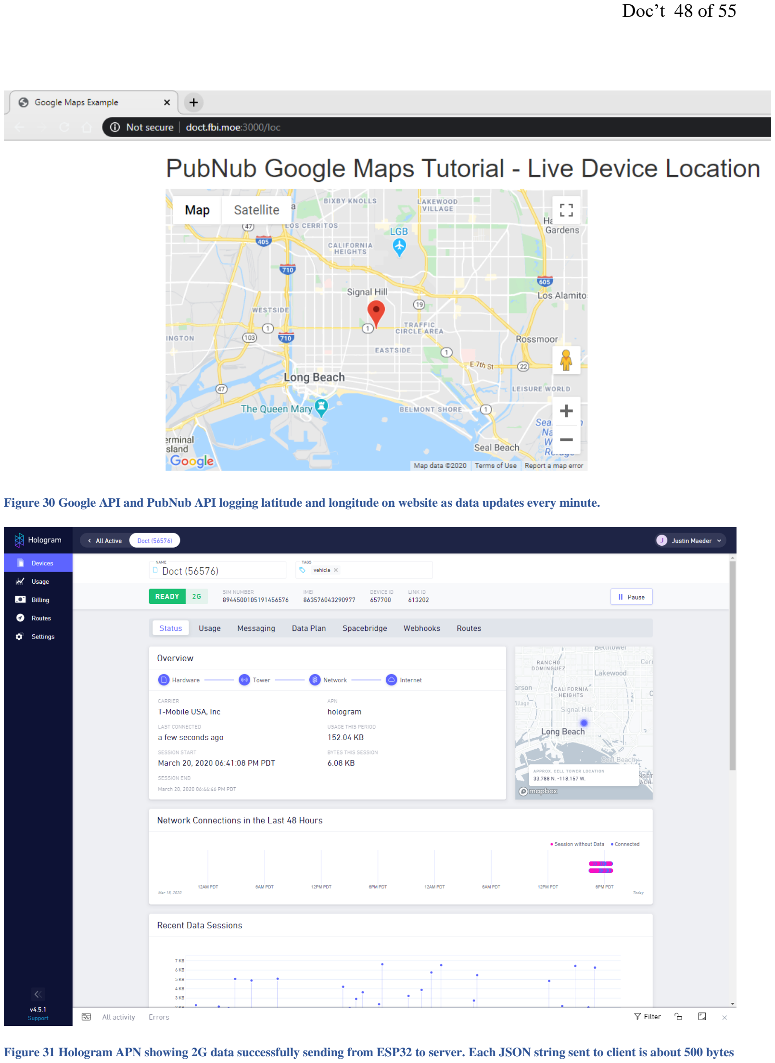
[picture p56: page 48]

Figure 30 Google API and PubNub API logging latitude and longitude on website as data updates every minute.

Figure 31 Hologram APN showing 2G data successfully sending from ESP32 to server. Each JSON string sent to client is about 500 bytes

5. SOURCE CODE REPOSITORY

All source code in this project could be found at this repository.

https://github.com/JustinMaeder/Doct-senior-design-project

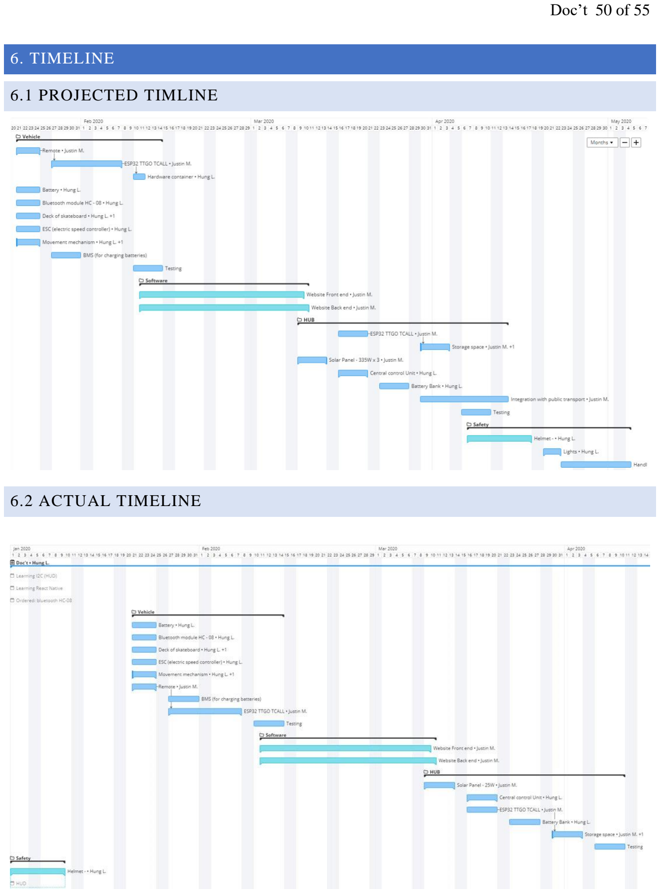
[picture p57: page 50]

6. TIMELINE

6.1 PROJECTED TIMLINE

6.2 ACTUAL TIMELINE

6.3 PROGRESS AGAINST TIMELINE

Since last semester our timeline has changed. The reason for this was due to a timing constraint where we only had two weeks before the first demonstration. For our first demo, we completed the Head Up Display as one of the main safety features. The first demo consisted of creating the HUD casing by modifying a 3D printed model. Inside the HUD casing was an Arduino nano, a HM-10 Bluetooth transceiver, connected to an OLED display. The Arduino nano is programmed in the IDE to accept a string to change the speed, battery, and range. This information is displayed on the HUD acrylic display which is attached to the helmet. The current time was also displayed in the first demo. The HUD was changed to the first task as it was a standalone system that has no dependencies on other components.

Starting from the third demo, we must work separately. This will slow down our progress but not by a significant amount since our project is divided in such a way that all parts are manageable by one person. The server components are managed by one person and can be easily collaborated online. But the next part of assembling the HUB, will have to be done differently. The major electronics of the HUB can be done by one person. But the physical locker space and charging assembly will need to be down sized so that it is more manageable by one person.

7. DATA SHEET

7.1 HEAD UP DISPLAY

Arduino Nano:

https://store.arduino.cc/usa/arduino-nano

HM-10:

https://people.ece.cornell.edu/land/courses/ece4760/PIC32/uart/HM10/DSD%20TECH%20HM-10%20datasheet.pdf (https://people.ece.cornell.edu/land/courses/ece4760/PIC32/uart/HM10/DSD%20TECH%20HM-10%20datasheet.pdf)

128x64 SSD1306 OLED display:

https://www.vishay.com/docs/37902/oled128o064dbpp3n00000.pdf

Adafruit MicroLipo battery charger:

https://learn.adafruit.com/adafruit-microlipo-and-minilipo-battery-chargers/downloads

Arduino Libraries:

https://www.arduino.cc/en/reference/libraries

7.2 VEHICLE

TinyGPS++ library:

http://arduiniana.org/libraries/tinygpsplus/

ESP32 Bluetooth connection:

https://randomnerdtutorials.com/esp32-sim800l-publish-data-to-cloud/

GPS:

https://www.instructables.com/id/ESP32-GPS-Tracker-With-an-OLED-Display/

7.3 SERVER

Hackathon Boiler Plate GitHub:

https://github.com/sahat/hackathon-starter

MongoDB

https://docs.mongodb.com/guides/

TinyGPS++ library:

http://arduiniana.org/libraries/tinygpsplus/

8. OUTSTANDING CONCERNS AND EXPECTED PATH TO RESOLUTION

Our first major concern is finishing the vehicle platform. This means creating the mechanics of the scooter/ skateboard hybrid. This goes out of our realm of Computer Engineering, so we are reaching out to a mechanical engineer for assistance. Our second concern is cost. We might scale down our production for example we might obtain a smaller solar panel and save about $80.

One setback that we have encountered is that one of our ESP32 TTGO T-Call is no longer functional due to misuse. A new ESP32 is on order, but the delivery date is unknown due to the new situations.

With the new situation that prevents us from working together in the same location, we must adapt our original plan. This means that the integration of the scooter will be put on hold because it will be difficult for us to meet with our contributor Taylor to research and develop the transformable handlebar. So, we have decided to suspend this idea.

9. DESCRIPTION OF TOOLS USED, METHODOLOGIES

For the programming of the Arduino Nano in the Head Up Display, we utilized Arduino IDE to display the updated graphics for the user to view the vitals of the board. We are also using Arduino IDE to program the ESP32 TTGO TCALL. For the 3D printed HUD casing we used Fusion 360 and modified a previous design to make it larger to fit our components.

In order to create our timeline of tasks, we used Wrike to make a task list which was easily converted into a Gannt chart. We communicated through Discord and kept track of our reference on there. Lastly, we shared files through Microsoft OneDrive because it was the easiest platform provided by the school to keep track of updated files.

10. CONTRIBUTORS

We can’t do everything on our own, so we have recruited some contributors. First, Taylor Smyth at Avalon Sheet Metal helped us with the Database. Next, Long Le supported us with the 3D CAD throughout the project.

Taylor Smyth at Avalon Sheet Metal | Long Le at ANDesign Lab

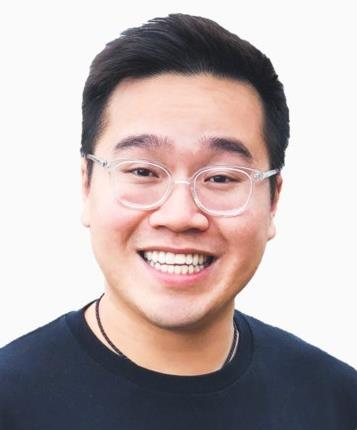
[picture p58: figure]
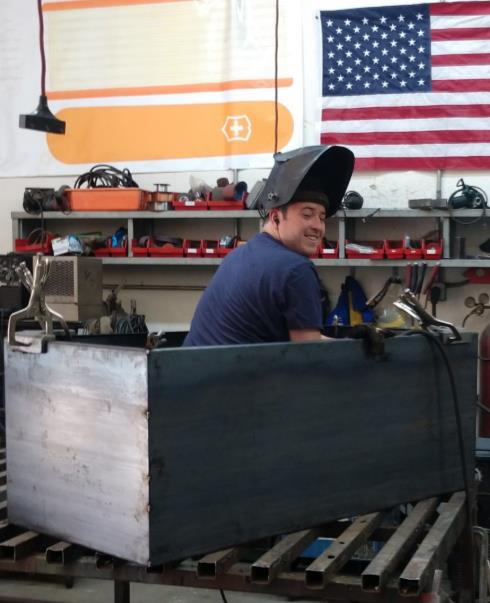
[picture p59: figure]

11. REFERENCES

Electric skateboard:

- Motor drive system: https://www.youtube.com/watch?v=opg3h62p0gc
- Electric Skateboard: http://www.brokking.net/longboard_main.html
- Battery selection: http://mustcalculate.com/electronics/batterycapacity.php
- Motor selection: https://www.youtube.com/watch?v=rD7O4DV-D5k
- https://www.quora.com/What-kind-of-motor-is-need-to-build-an-electric-skateboard (https://www.quora.com/What-kind-of-motor-is-need-to-build-an-electric-skateboard)
- ESC module: https://www.youtube.com/watch?v=LJqyWRSqOy4&t=4s
- HUD design: https://hackaday.io/project/12211-arduino-glasses-a-hmd-for-multimeter
- https://www.youtube.com/watch?v=IpJqzwXWg-k
- Solar panel efficiency: https://magesolar.com/solar-angle-calculator/
- Solar panel: https://www.santansolar.com/sunpower-p17-335w/
- Bluetooth module setup: http://www.martyncurrey.com/hm-10-bluetooth-4ble-modules/#Bluetooth_4_BLE (http://www.martyncurrey.com/hm-10-bluetooth-4ble-modules/#Bluetooth_4_BLE)
- ESP32 cellular: https://hackaday.com/2019/07/09/new-part-day-the-15-esp32-with-cellular/ (https://hackaday.com/2019/07/09/new-part-day-the-15-esp32-with-cellular/)
- OLED display: https://www.vishay.com/docs/37902/oled128o064dbpp3n00000.pdf

Database:

- ESP32 Arduino: Timer Interrupts: https://techtutorialsx.com/2017/10/07/esp32-arduino-

timer-interrupts/ (https://techtutorialsx.com/2017/10/07/esp32-arduino-timer-interrupts/)

- Installing ESP32 in Arduino IDE: https://randomnerdtutorials.com/installing-the-esp32-

board-in-arduino-ide-windows-instructions/ (https://randomnerdtutorials.com/installing-the-esp32-board-in-arduino-ide-windows-instructions/)

- Connecting ESP32 to Wi-Fi Network: https://circuits4you.com/2019/01/05/connecting-

esp32-to-wifi-network/ (https://circuits4you.com/2019/01/05/connecting-esp32-to-wifi-network/)

- ESP32 Publish Data to Cloud without Wi-Fi:

https://www.youtube.com/watch?time_continue=183&v=aCeVsySh-

v4&feature=emb_logo (https://www.youtube.com/watch?time_continue=183&v=aCeVsySh-v4&feature=emb_logo)

- Server.js simple TCP server: https://riptutorial.com/node-js/example/22405/a-simple-tcp-

server (https://riptutorial.com/node-js/example/22405/a-simple-tcp-server)
